ethycS0/risc-v-apu/src/ID_stage/instruction_decode_stage.vhd

--! @file instruction_decode_stage.vhd
--! @brief Instruction Decode (ID) pipeline stage for the RISC-V processor.
--! @author ethycS
--! @details This module coordinates instruction decoding, general-purpose register file (GPR) accesses,
--! immediate value reconstruction, and pipeline control signal generation.
--!
--! Key security integrations:
--! - **Zicfilp (Landing Pads)**: If the Fetch stage signals an Expected Landing Pad (`elp_active`),
--!   the stage forces `rs1_addr` to `"00111"` (register x7/t2, which holds the expected label).
--!   This fetches the expected label from the GPR, enabling the Execution stage to verify it
--!   against the immediate label of the `lpad` instruction.
--! - **Smcfiss (Shadow Stack)**: Decodes shadow stack push/pop instructions (`sspush` / `sspop`),
--!   routing them as custom CSR/memory accesses to push/pop from the shadow stack pointer CSR (`ssp`).
--! - **PMP Fault Propagation**: If a PMP fault occurred during instruction fetch, the control signals
--!   (`mem_read`, `mem_write`, `reg_write`) are suppressed, and the instruction is forced to a NOP
--!   with the exception tag propagated.

LIBRARY ieee;
USE ieee.std_logic_1164.ALL;
USE ieee.numeric_std.ALL;
USE work.rv32i_pkg.ALL;

ENTITY instruction_decode_stage IS
	PORT (
		i_clk : IN STD_LOGIC;  --! Global clock (rising-edge active)
		i_rst : IN STD_LOGIC;  --! Asynchronous reset (Active High)

		i_wb_id_bus : IN  t_rd_reg_data;  --! Writeback feedback bus (register write address and data from WB stage)
		i_if_id_bus : IN  t_if_id_data;   --! Input bus from Instruction Fetch stage (instruction, PC, faults)
		o_id_ex_bus : OUT t_id_ex_data    --! Output bus to Execute stage (decoded signals and control flags)
	);
END ENTITY instruction_decode_stage;

ARCHITECTURE structural OF instruction_decode_stage IS

	--! Control unit component declaration
	COMPONENT id_control_unit IS
		PORT (
                        i_elp         : IN  STD_LOGIC;
			i_instruction : IN  STD_LOGIC_VECTOR(31 DOWNTO 0);
			o_reg_write   : OUT STD_LOGIC;
			o_mem_read    : OUT STD_LOGIC;
			o_mem_write   : OUT STD_LOGIC;
			o_src_a       : OUT t_SrcA;
			o_src_b       : OUT t_SrcB;
			o_wb_src      : OUT t_WritebackSrc;
			o_opr_unit    : OUT t_OprUnit;
			o_opr_type    : OUT t_OprType
		);
	END COMPONENT id_control_unit;

	--! Immediate reconstruction unit component declaration
	COMPONENT immediate_reconstruct_unit IS
		PORT (
			i_instruction : IN  STD_LOGIC_VECTOR(31 DOWNTO 0);
			o_immediate   : OUT STD_LOGIC_VECTOR(31 DOWNTO 0)
		);
	END COMPONENT immediate_reconstruct_unit;

	--! Register file component declaration
	COMPONENT register_file IS
		PORT (
			i_clk      : IN  STD_LOGIC;
			i_rst      : IN  STD_LOGIC;
			i_wr_en    : IN  STD_LOGIC;
			i_wr_addr  : IN  STD_LOGIC_VECTOR(4 DOWNTO 0);
			i_wr_data  : IN  STD_LOGIC_VECTOR(31 DOWNTO 0);
			i_rd1_addr : IN  STD_LOGIC_VECTOR(4 DOWNTO 0);
			o_rd1_data : OUT STD_LOGIC_VECTOR(31 DOWNTO 0);
			i_rd2_addr : IN  STD_LOGIC_VECTOR(4 DOWNTO 0);
			o_rd2_data : OUT STD_LOGIC_VECTOR(31 DOWNTO 0)
		);
	END COMPONENT register_file;

	SIGNAL s_rs1_addr  : STD_LOGIC_VECTOR(4 DOWNTO 0);  --! Source register 1 address (instruction[19:15] or x7 for LPAD label)
	SIGNAL s_rs2_addr  : STD_LOGIC_VECTOR(4 DOWNTO 0);  --! Source register 2 address (instruction[24:20])
	SIGNAL s_uimm      : STD_LOGIC_VECTOR(4 DOWNTO 0);  --! Unsigned immediate/Zimm for CSR instructions (instruction[19:15])
	SIGNAL s_rd_addr   : STD_LOGIC_VECTOR(4 DOWNTO 0);  --! Destination register address (instruction[11:7])
	SIGNAL s_funct3    : STD_LOGIC_VECTOR(2 DOWNTO 0);  --! Function field 3 bits (instruction[14:12])
	SIGNAL s_funct12   : STD_LOGIC_VECTOR(11 DOWNTO 0); --! Function field 12 bits for system instructions (instruction[31:20])

        SIGNAL elp_tag     : STD_LOGIC := '0';              --! Internal Expected Landing Pad status flag
        SIGNAL s_fault_tag : t_fault_tag := VALID;          --! Internal fault tag propagated down the pipeline

        SIGNAL s_mem_read  : STD_LOGIC := '0';              --! Temporary decode memory read enable
        SIGNAL s_mem_write : STD_LOGIC := '0';              --! Temporary decode memory write enable
        SIGNAL s_reg_write : STD_LOGIC := '0';              --! Temporary decode register file write enable
        SIGNAL s_opr_type  : t_OprType := OP_R_TYPE;        --! Temporary decode operation type

BEGIN
        elp_tag <= '1' WHEN i_if_id_bus.elp_active = '1' ELSE '0';

        --! @brief Fault tag propagation process
        --! @details Carries fetch-stage faults forward and classifies illegal instructions.
        P_FAULT_TAG : PROCESS (ALL)
        BEGIN
                s_fault_tag <= i_if_id_bus.fault_tag;
                IF i_if_id_bus.fault_tag = VALID THEN 
                        IF o_id_ex_bus.opr_type = OP_ILLEGAL THEN
                                -- s_fault_tag <= ID_INVALID_INSTR; Commented cuz RISCOF
                        END IF;
                END IF;
        END PROCESS P_FAULT_TAG;

	-- Extract instruction fields from the incoming instruction.
	-- For Landing Pad label comparison (Zicfilp), rs1 is forced to x7 ("00111") where the expected label is stored.
        s_rs1_addr <= "00111" WHEN elp_tag = '1' ELSE i_if_id_bus.instruction(19 DOWNTO 15);  -- Source register 1
	s_rs2_addr <= i_if_id_bus.instruction(24 DOWNTO 20);  -- Source register 2
	s_rd_addr  <= i_if_id_bus.instruction(11 DOWNTO 7);   -- Destination register
	s_funct3   <= i_if_id_bus.instruction(14 DOWNTO 12);  -- Funct3 for ALU/Memory/Branch operation selection
	s_funct12  <= i_if_id_bus.instruction(31 DOWNTO 20);  -- CSR address or system instruction encoding
	s_uimm     <= i_if_id_bus.instruction(19 DOWNTO 15);  -- Unsigned immediate for CSR immediate instructions

	--! @brief Control Unit Instance
	--! @details Decodes the instruction opcode and generates all pipeline control signals
	U_DECODE_CONTROL : id_control_unit
	PORT MAP(
                i_elp         => elp_tag,
		i_instruction => i_if_id_bus.instruction,
		o_reg_write   => s_reg_write,
		o_mem_read    => s_mem_read,
		o_mem_write   => s_mem_write,
		o_src_a       => o_id_ex_bus.src_a,
		o_src_b       => o_id_ex_bus.src_b,
		o_wb_src      => o_id_ex_bus.wb_src,
		o_opr_unit    => o_id_ex_bus.opr_unit,
		o_opr_type    => s_opr_type
	);

	--! @brief Immediate Reconstruction Unit Instance
	--! @details Extracts and reconstructs immediate values from scattered instruction bits
	U_IMMEDIATE_CONSTRUCTOR : immediate_reconstruct_unit
	PORT MAP(
		i_instruction => i_if_id_bus.instruction,
		o_immediate   => o_id_ex_bus.immediate
	);

	--! @brief Register File Instance
	--! @details Dual-port read, single-port write register file with internal forwarding
	U_REGISTER_FILE : register_file
	PORT MAP(
		i_clk      => i_clk,
		i_rst      => i_rst,
		i_wr_en    => i_wb_id_bus.reg_write_en,
		i_wr_addr  => i_wb_id_bus.rd_addr,
		i_wr_data  => i_wb_id_bus.rd_data,
		i_rd1_addr => s_rs1_addr,
		i_rd2_addr => s_rs2_addr,
		o_rd1_data => o_id_ex_bus.rs1_data,
		o_rd2_data => o_id_ex_bus.rs2_data
	);

	--! @brief Forward PC and PC+4 from IF stage to EX stage
	o_id_ex_bus.pc  <= i_if_id_bus.pc;
	o_id_ex_bus.pc4 <= i_if_id_bus.pc4;

	-- Forward instruction fields to EX stage
	o_id_ex_bus.rd_addr  <= s_rd_addr;
	o_id_ex_bus.rs1_addr <= s_rs1_addr;
	o_id_ex_bus.rs2_addr <= s_rs2_addr;
	o_id_ex_bus.uimm     <= s_uimm;

	-- Forward function fields to EX stage for operation decoding
	o_id_ex_bus.funct3    <= s_funct3;
	o_id_ex_bus.funct12   <= s_funct12;
        o_id_ex_bus.fault_tag <= s_fault_tag;
        o_id_ex_bus.elp_active <= i_if_id_bus.elp_active;

        -- Suppress control signals and force OP_R_TYPE (acting as NOP) if a fault has been detected
        o_id_ex_bus.mem_read  <= s_mem_read  WHEN s_fault_tag = VALID ELSE '0';
        o_id_ex_bus.mem_write <= s_mem_write WHEN s_fault_tag = VALID ELSE '0';
        o_id_ex_bus.reg_write <= s_reg_write WHEN s_fault_tag = VALID ELSE '0';
        o_id_ex_bus.opr_type  <= s_opr_type  WHEN s_fault_tag = VALID ELSE OP_R_TYPE;

END ARCHITECTURE structural;
