ethycS0/risc-v-apu/software/apps/ascii-tetris/tetris.c

#include "tetris.h"
#include "debug.h"
#include "uart.h"
#include <stdio.h>
#include <stdlib.h>

#define CPU_FREQ_HZ 27000000

unsigned long get_cycles(void) {
        unsigned long cycles;
        // "csrr" = Control Status Register Read
        __asm__ volatile("csrr %0, mcycle" : "=r"(cycles));
        return cycles;
}

void delay(unsigned int ms) {
        unsigned long start_time = get_cycles();
        unsigned long cycles_to_wait = ms * (CPU_FREQ_HZ / 1000);

        while ((get_cycles() - start_time) < cycles_to_wait) {
                __asm__("NOP");
        }
}

struct tetris_level {
        int score;
        int nsec;
};

struct tetris {
        char **game;
        int w;
        int h;
        int level;
        int gameover;
        int score;
        struct tetris_block {
                char data[5][5];
                int w;
                int h;
        } current;
        int x;
        int y;
};

struct tetris_block blocks[] = {{{"##", "##"}, 2, 2},       {{" X ", "XXX"}, 3, 2},     {{"@@@@"}, 4, 1},
                                {{"OO", "O ", "O "}, 2, 3}, {{"&&", " &", " &"}, 2, 3}, {{"ZZ ", " ZZ"}, 3, 2}};

struct tetris_level levels[] = {{0, 1200000},    {1500, 900000},  {8000, 700000},  {20000, 500000},
                                {40000, 400000}, {75000, 300000}, {100000, 200000}};

#define TETRIS_PIECES (sizeof(blocks) / sizeof(struct tetris_block))
#define TETRIS_LEVELS (sizeof(levels) / sizeof(struct tetris_level))

void tetris_init(struct tetris *t, int w, int h) {
        t->level = 1;
        t->score = 0;
        t->gameover = 0;
        t->w = w;
        t->h = h;

        t->game = (char **)malloc(sizeof(char *) * w);
        if (t->game == NULL) {
                printf("[FATAL] Malloc failed for game columns! Heap exhausted?\n");
                t->gameover = 1;
                return;
        }

        for (int x = 0; x < w; x++) {
                t->game[x] = (char *)malloc(sizeof(char) * h);
                if (t->game[x] == NULL) {
                        printf("[FATAL] Malloc failed at column %d! Heap exhausted?\n", x);
                        t->gameover = 1;
                        return;
                }
                for (int y = 0; y < h; y++) {
                        t->game[x][y] = ' ';
                }
        }
}

void tetris_clean(struct tetris *t) {
        int x;
        for (x = 0; x < t->w; x++) {
                free(t->game[x]);
        }
        free(t->game);
}

void tetris_print(struct tetris *t) {
        int x, y;
        // ANSI ESCAPE CODES:
        // \033[2J   = Clear Screen
        // \033[H    = Move Cursor to Top-Left
        // \033[?25l = Hide Cursor
        // printf("\033[2J\033[H\033[?25l");
        printf("\033[H\033[?25l");

        printf("[LEVEL: %d | SCORE: %d]\n", t->level, t->score);
        for (x = 0; x < 2 * t->w + 2; x++)
                printf("~");
        printf("\n");
        for (y = 0; y < t->h; y++) {
                printf("!");
                for (x = 0; x < t->w; x++) {
                        if (x >= t->x && y >= t->y && x < (t->x + t->current.w) && y < (t->y + t->current.h) &&
                            t->current.data[y - t->y][x - t->x] != ' ')
                                printf("%c ", t->current.data[y - t->y][x - t->x]);
                        else
                                printf("%c ", t->game[x][y]);
                }
                printf("!\n");
        }

        for (x = 0; x < 2 * t->w + 2; x++)
                printf("~");
        printf("\n");
}

int tetris_hittest(struct tetris *t) {
        int x, y, X, Y;
        struct tetris_block b = t->current;
        for (x = 0; x < b.w; x++)
                for (y = 0; y < b.h; y++) {
                        X = t->x + x;
                        Y = t->y + y;
                        if (X < 0 || X >= t->w)
                                return 1;
                        if (b.data[y][x] != ' ') {
                                if ((Y >= t->h) || (X >= 0 && X < t->w && Y >= 0 && t->game[X][Y] != ' ')) {
                                        return 1;
                                }
                        }
                }
        return 0;
}

void tetris_new_block(struct tetris *t) {
        t->current = blocks[random() % TETRIS_PIECES];
        t->x = (t->w / 2) - (t->current.w / 2);
        t->y = 0;
        if (tetris_hittest(t)) {
                t->gameover = 1;
        }
}

void tetris_print_block(struct tetris *t) {
        int x, y, X, Y;
        struct tetris_block b = t->current;
        for (x = 0; x < b.w; x++)
                for (y = 0; y < b.h; y++) {
                        if (b.data[y][x] != ' ')
                                t->game[t->x + x][t->y + y] = b.data[y][x];
                }
}

void tetris_rotate(struct tetris *t) {
        struct tetris_block b = t->current;
        struct tetris_block s = b;
        int x, y;
        b.w = s.h;
        b.h = s.w;
        for (x = 0; x < s.w; x++)
                for (y = 0; y < s.h; y++) {
                        b.data[x][y] = s.data[s.h - y - 1][x];
                }
        x = t->x;
        y = t->y;
        t->x -= (b.w - s.w) / 2;
        t->y -= (b.h - s.h) / 2;
        t->current = b;
        if (tetris_hittest(t)) {
                t->current = s;
                t->x = x;
                t->y = y;
        }
}

void tetris_gravity(struct tetris *t) {
        int x, y;
        t->y++;
        if (tetris_hittest(t)) {
                t->y--;
                tetris_print_block(t);
                tetris_new_block(t);
        }
}

void tetris_fall(struct tetris *t, int l) {
        int x, y;
        for (y = l; y > 0; y--) {
                for (x = 0; x < t->w; x++)
                        t->game[x][y] = t->game[x][y - 1];
        }
        for (x = 0; x < t->w; x++)
                t->game[x][0] = ' ';
}

void tetris_check_lines(struct tetris *t) {
        int x, y, l;
        int p = 100;
        for (y = t->h - 1; y >= 0; y--) {
                l = 1;
                for (x = 0; x < t->w && l; x++) {
                        if (t->game[x][y] == ' ') {
                                l = 0;
                        }
                }
                if (l) {
                        t->score += p;
                        p *= 2;
                        tetris_fall(t, y);
                        y++;
                }
        }
}

int tetris_level(struct tetris *t) {
        int i;
        for (i = 0; i < TETRIS_LEVELS; i++) {
                if (t->score >= levels[i].score) {
                        t->level = i + 1;
                } else
                        break;
        }
        return levels[t->level - 1].nsec;
}

void tetris_run(int w, int h) {
        struct tetris t;
        unsigned char cmd;
        int count = 0;
        tetris_init(&t, w, h);
        srand(get_cycles());
        int game_speed = 1;

        tetris_new_block(&t);
        while (!t.gameover) {
                count++;
                if (count % 50 == 0) {
                        DEBUG_UPDATE();
                        tetris_print(&t);
                }
                if (count % 350 == 0) {
                        tetris_gravity(&t);
                        tetris_check_lines(&t);
                }
                while ((uart_getc(&cmd)) > 0) {
                        switch (cmd) {
                        case 'a':
                                t.x--;
                                if (tetris_hittest(&t))
                                        t.x++;

                                DEBUG_UPDATE();
                                break;
                        case 'd':
                                t.x++;
                                if (tetris_hittest(&t))
                                        t.x--;

                                DEBUG_UPDATE();
                                break;
                        case 's':
                                tetris_gravity(&t);

                                DEBUG_UPDATE();
                                break;
                        case ' ':
                                tetris_rotate(&t);

                                DEBUG_UPDATE();
                                break;
                        }
                }

                delay(game_speed);
        }

        tetris_print(&t);
        printf("*** GAME OVER ***\n");
        // Show the cursor again (\033[?25h)
        printf("\033[?25h");

        tetris_clean(&t);
}
