ethycS0/risc-v-apu/(commit log)

2025-11-10 Changed Decode Stage and ALU stage for more performant code, remaining for execution stage: Branching Logic. Memory and Writeback and completre integration.
2025-11-12 Finalized all CPU components. Remaining: Instruction Stage Unit, Hazard Detection, Complete CPU
2025-11-13 Added Forwarding Unit for dealing with forward hazards. Added Instruction Decode Stage. Only complete CPU and Hazard Handelling remains.
2025-11-14 Fixed Data Hazards for forwarding and load-and-use instructions
    [hazard_detection_unit.vhd, rv32i.vhd]
2025-11-21 Working RISC V Assembly and Running on tb_core
2025-11-30 Switched from custom toolchain to riscv32-none-elf-
2025-12-30 Created UART implementation and testbench
2026-01-03 Fixed Data read delay 2 to 1. Fixed UART combinational read to 1 cycle delayed. Hello World works
    [common.vhd, core.vhd, execution_stage.vhd, memory_stage.vhd, soc.vhd, tb_soc.vhd, writeback_stage.vhd]
2026-01-08 Bootstrap C working with UART
2026-01-09 ASCII Tetris working on eSC-V
2026-02-13 Added hardware for Misalign Data Access
    [common.vhd, core.vhd, execution_stage.vhd, memory_stage.vhd]
2026-02-13 Added Trap for misaligned jumps and branches, configured spike for RISCOF
    [common.vhd, core.vhd, execution_stage.vhd, memory_stage.vhd]
2026-02-15 Implemneted PMP unit, some tests pass. RISCOF misconfiguration probably for fail
    [common.vhd, core.vhd, csr_unit.vhd, execution_stage.vhd, instruction_decode_stage.vhd, instruction_fetch_stage.vhd, memory_stage.vhd]
2026-02-22 Fixed PMP unit (RISCOF all pass for RV32I), rewriting Zicfiss
    [common.vhd, csr_unit.vhd, pmp_unit.vhd, soc.vhd]
2026-03-01 Fixed bugs in PMP, SMCFISS and Flushing
    [branch_control_unit.vhd, common.vhd, core.vhd, csr_unit.vhd, ex_control_unit.vhd, execution_stage.vhd, hazard_detection_unit.vhd, immediate_reconstruct_unit.vhd]
2026-03-10 Fixed false LS Hazard with new Hazard Detection Unit
    [core.vhd, hazard_detection_unit.vhd, main.c]
2026-03-22 Finalized toolchain, fixed bugs and CFI chapter complete
    [execution_stage.vhd, main.c, tb_soc.vhd]
2026-03-28 Fixed Website, added core status debug
    [main.c, tetris.c]
2026-04-06 Added pages using react router and added Flash CPU button
2026-04-06 Fixed Python a regs parsing
    [demo_bridge.py]
2026-04-06 Fixed Viewport and terminal
    [demo_bridge.py, tetris.c]
2026-04-06 Flash CPU button works with frontend and backend and each program has a different bash
2026-04-06 Added JOP and ROP buttons in CFI dashboard
